SaintGimp/BatteryMonitor/board/BatteryMonitor.kicad_pcb

## KiCad design board/BatteryMonitor.kicad_pcb (2020-10-25)

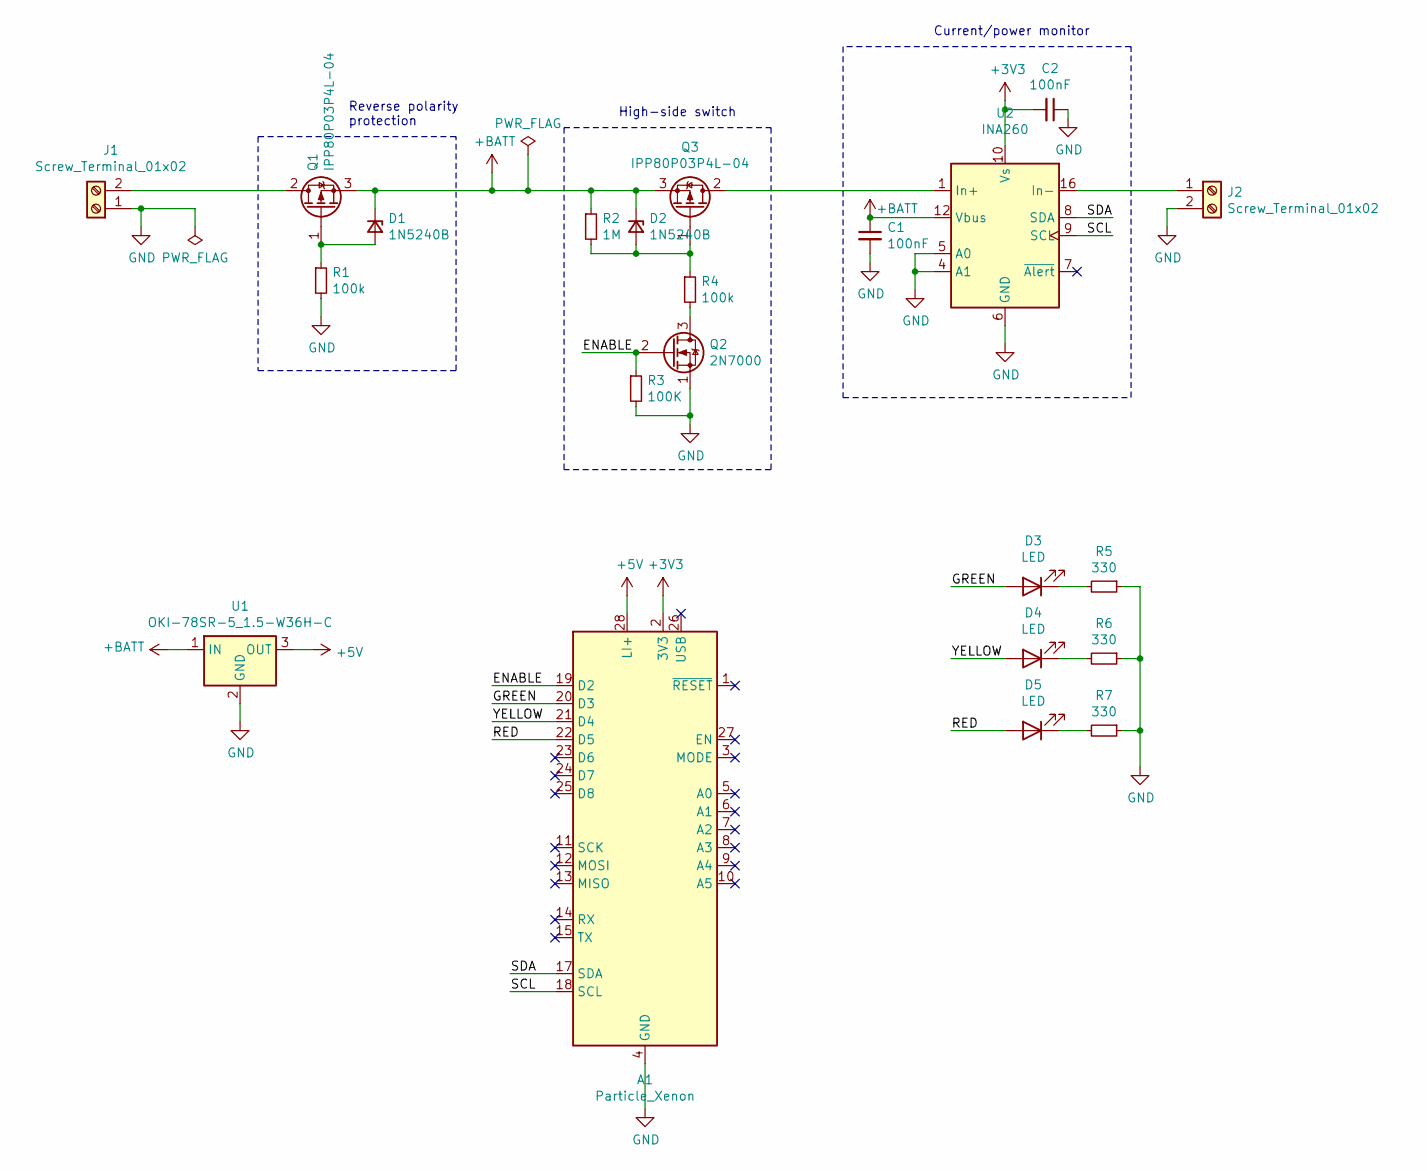
[picture p1: schematic BatteryMonitor.sch]

Parts:
A1: Particle_Xenon; Adafruit_Feather
C1, C2: 100nF; C_0805_2012Metric_Pad1.15x1.40mm_HandSolder
D1, D2: 1N5240B; D_DO-35_SOD27_P7.62mm_Horizontal
D3, D4, D5: LED; LED_D3.0mm
J1, J2: Screw_Terminal_01x02; TerminalBlock_Phoenix_MKDS-1,5-2-5.08_1x02_P5.08mm_Horizont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
Q1, Q3: IPP80P03P4L-04; TO-220-3_Horizontal_TabDown
Q2: 2N7000; TO-92_Inline
R1, R4: 100k; R_0805_2012Metric_Pad1.15x1.40mm_HandSolder
R2: 1M; R_0805_2012Metric_Pad1.15x1.40mm_HandSolder
R3: 100K; R_0805_2012Metric_Pad1.15x1.40mm_HandSolder
R5, R6, R7: 330; R_0805_2012Metric_Pad1.15x1.40mm_HandSolder
U1: OKI-78SR-5_1.5-W36H-C; Converter_DCDC_muRata_OKI-78SR_Horizontal
U2: INA260; TSSOP-16_4.4x5mm_P0.65mm

Connections:
+3V3: A1.2 (3V3), C2.2, U2.10 (Vs)
+5V: A1.28 (LI+), U1.3 (OUT)
+BATT: C1.1, D1.1 (K), D2.1 (K), Q1.3 (S), Q3.3 (S), R2.1, U1.1 (IN), U2.12 (Vbus)
/ENABLE: A1.19 (D2), Q2.2 (G), R3.1
/GREEN: A1.20 (D3), D3.2 (A)
/RED: A1.22 (D5), D5.2 (A)
/SCL: A1.18 (SCL), U2.9 (SCL)
/SDA: A1.17 (SDA), U2.8 (SDA)
/YELLOW: A1.21 (D4), D4.2 (A)
GND: A1.4 (GND), C1.2, C2.1, J1.1, J2.2, Q2.1 (S), R1.2, R3.2, R5.1, R6.1, R7.1, U1.2 (GND), U2.4 (A1), U2.5 (A0), U2.6 (GND), U2.11 (GND)
unnamed: D1.2 (A), Q1.1 (G), R1.1
unnamed: D2.2 (A), Q3.1 (G), R2.2, R4.1
unnamed: D3.1 (K), R5.2
unnamed: D4.1 (K), R6.2
unnamed: D5.1 (K), R7.2
unnamed: J1.2, Q1.2 (D)
unnamed: J2.1, U2.14 (In-), U2.15 (In-), U2.16 (In-)
unnamed: Q2.3 (D), R4.2
unnamed: Q3.2 (D), U2.1 (In+), U2.2 (In+), U2.3 (In+)

Notes on the sheet:
Reverse polarity protection
High-side switch
Current/power monitor

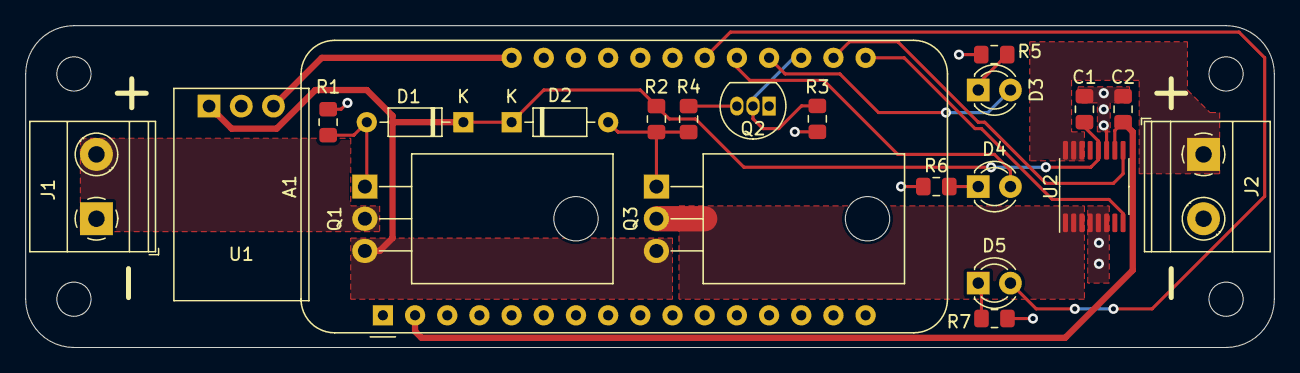
[picture p2: board BatteryMonitor.kicad_pcb from above]

Board: 2 copper layers, 98.6 x 25.4 mm, 22 parts (0 on the bottom side), 19 nets.
