SaintGimp/BatteryMonitor/(commit log)

2017-03-04 Module that monitors SLA battery charge level and cuts the supply if the charge gets too low
    [BatteryMonitor.brd, BatteryMonitor.sch]
2020-10-08 V2 schematic
    [BatteryMonitor.brd, BatteryMonitor.kicad_pcb, BatteryMonitor.sch]
2020-10-08 Assign footprints and begin board layout
    [BatteryMonitor.kicad_pcb, BatteryMonitor.sch]
2020-10-25 Finish layout, first spin
    [BatteryMonitor.kicad_pcb, BatteryMonitor.sch]
2021-06-22 Average the voltage for more consistent response
